Trip93/teensy4_mouse/README.md

# teensy4_mouse
Arduino code for a high speed 8000Hz wired mouse using a teensy 4 MCU. 
This code is inspired by https://github.com/mrjohnk/PMW3360DM-T2QU and https://github.com/SunjunKim/PMW3360_Arduino.

This project includes code for a modified 8000Hz wired mouse.
It uses standard libraries included with the arduino IDE and teensyduino. 

Hardware relevant for this project:

PMW3360 image sensor https://www.pixart.com/products-detail/10/PMW3360DM-T2QU

Teensy4 microcontroller development board https://www.pjrc.com/store/teensy40.html 

Glorious Model O wired version. https://www.pcgamingrace.com/products/glorious-model-o-black

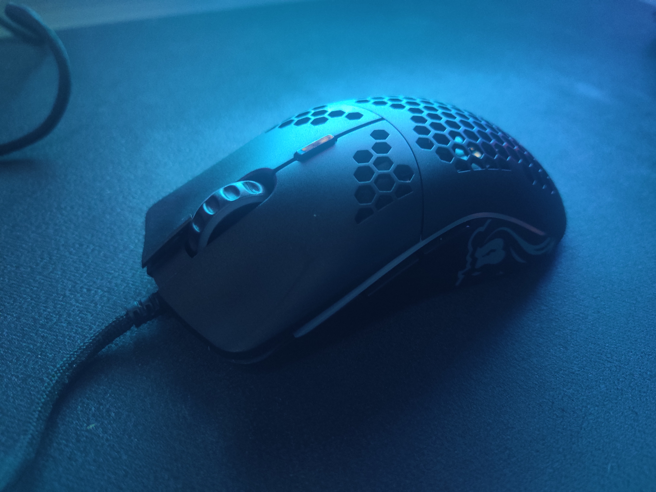
[picture p1: pictures/mouse_top_closed.jpg]

Glorious mouse modified with the teensy internally.

The following connection need to be made to the mouse sensor. The power supply pins are already taken care of by the mouse itself.
The microcontroller of the mouse should also be removed. Recommended is to use a hot air station to remove the microcontroller. 
It should be possible to do this project with any mouse that uses a PMW3360 sensor.
A pinout is given below: 

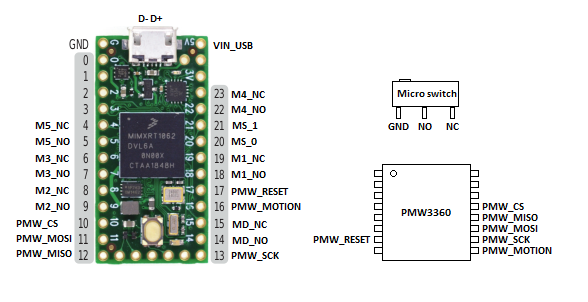
[picture p2: pictures/teensy4_mouse_pinout.png]


The teensy4 uses a microcontroller capable of USB high speed and therefore high polling speed (8000Hz). 
No drivers are required to enable 8000Hz. Signal integrity of the cable is important. 
The cable of the glorious mouse was shortened to 1 meter length and USB data lines were soldered straight to the Teensy4 D- and D+ pads. 
Picture of the modified mouse are given below:

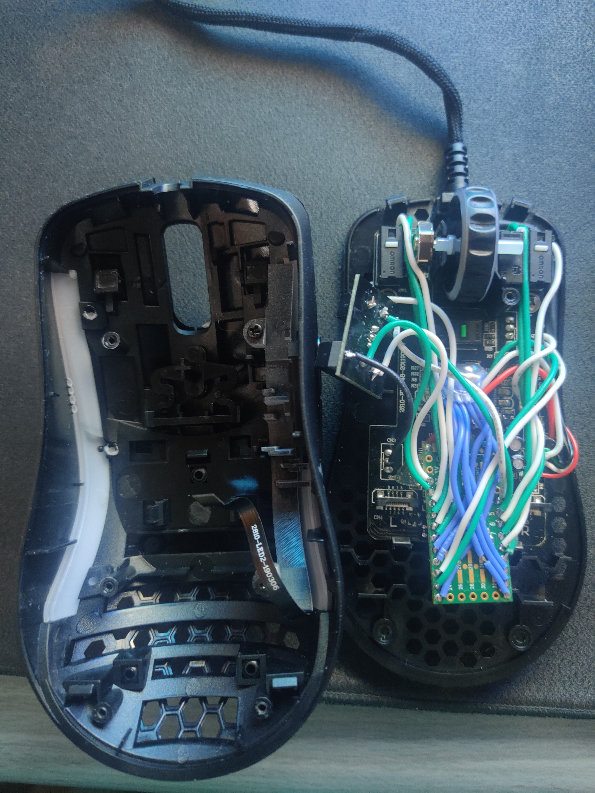
[picture p3: pictures/mouse_top_open.jpg]

Modified mouse top view open shell.

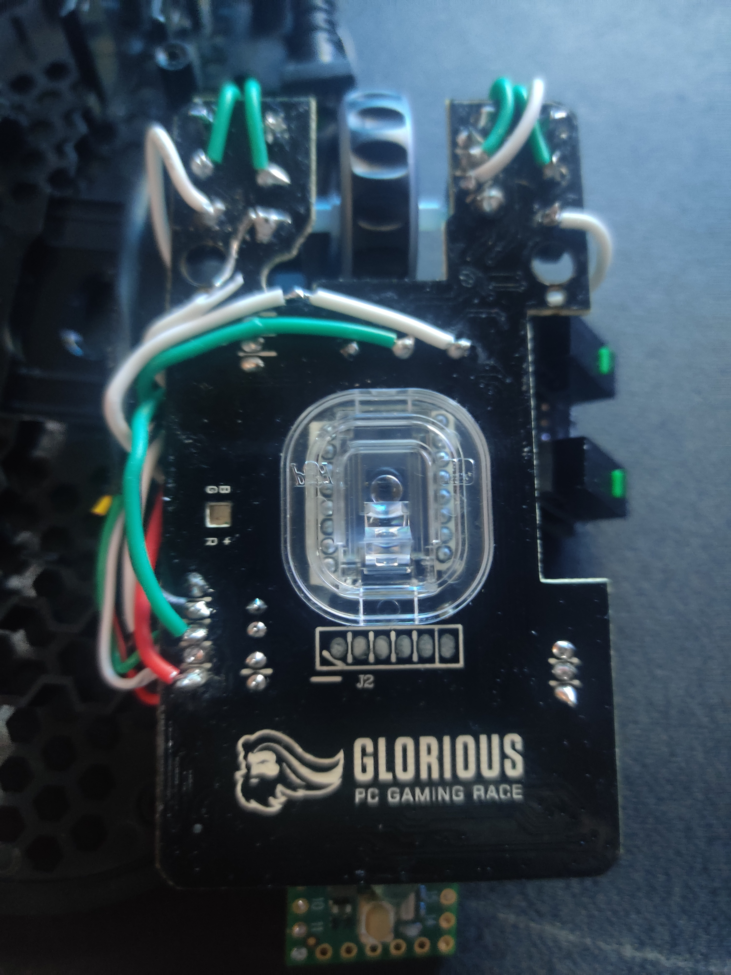
[picture p4: pictures/mouse_bottom_open.jpg]

Modified mouse bottom view open shell.

To verify 8000Hz operation mousetester1.5.3 was used https://www.overclock.net/threads/mousetester-software-reloaded.1590569/ 

Polling rate is limited by the speed at which the user moves the mouse. The graph has shows what happens when the user moves the mouse at varying speeds. 
At low speeds polling rates are closer to a 1000-2000Hz (0.5 - 1mS intervals), moderate speeds average at 4000hz (0.250ms intervals) and high speeds average at 8000Hz.
The PWM3360 adjusts the sensor framerate based on the speed that the user moves it. This can be up to 12000fps.

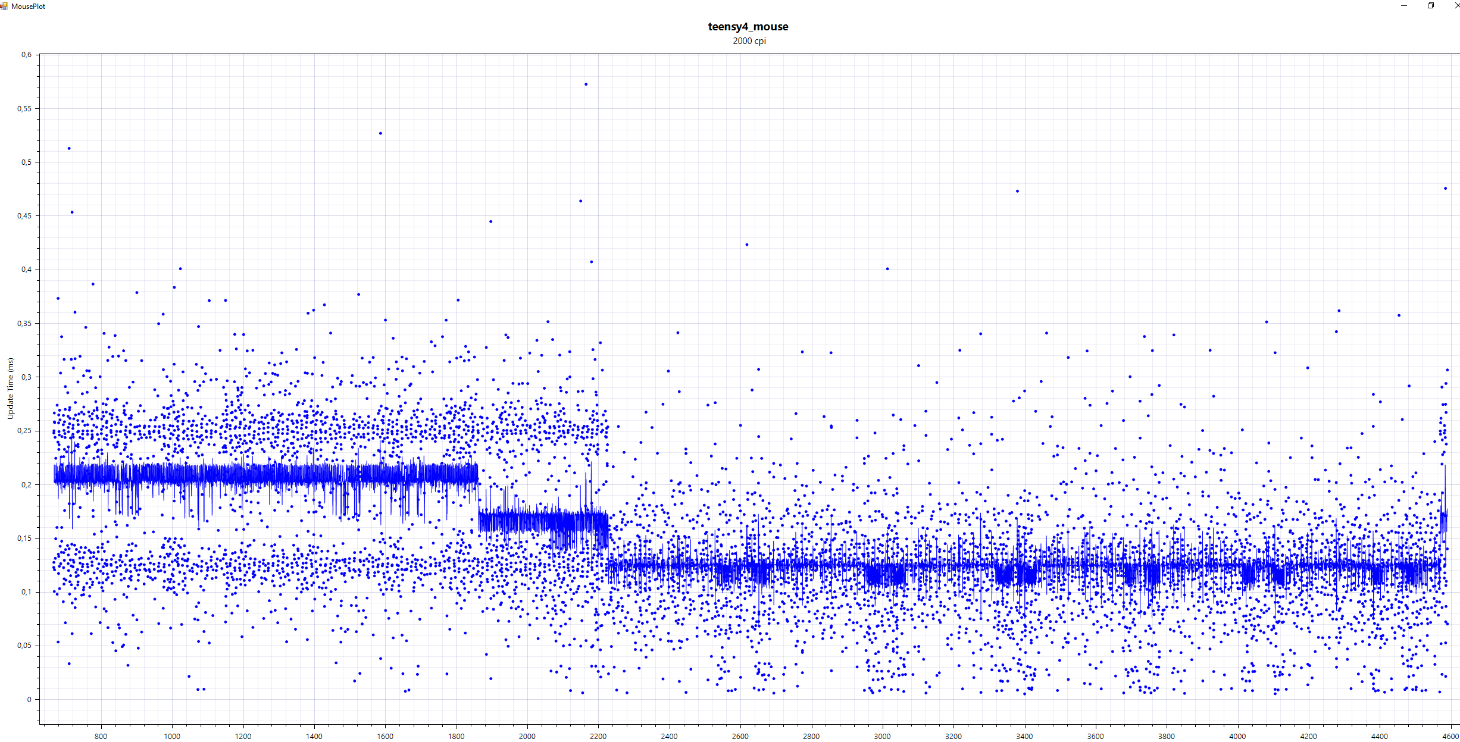
[picture p5: pictures/mousetester_teensy_mouse.png]


Furthermore this modification supports fast button inputs without software based debouncing. 
Both NC and NO connectors of the micro switch are connected to the microcontroller. Enabling fast state change detection without contact bounce problems.

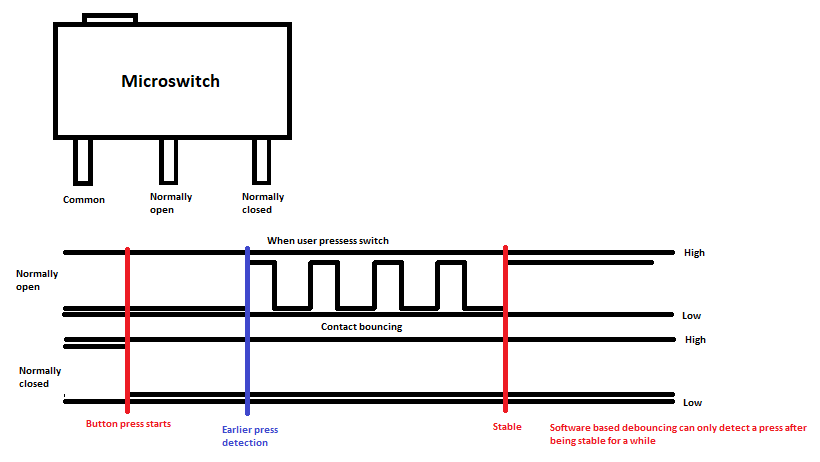
[picture p6: pictures/NC_NO_debouncing.png]


Related links:

If you would like to discuss something about this project I have posted a thread about this project on a few forums.

https://www.overclock.net/threads/8000hz-diy-teensy-4-mouse.1794842/#post-28889289

https://forums.blurbusters.com/viewtopic.php?f=7&p=73567#p73567

https://forum.pjrc.com/threads/68553-Teensy-4-high-speed-mouse

During the build process I also shot some video footage. It is possible that I will release a video somewhere in the (near) future. (no promises)
Since I am not very experienced with video editing and the footage is not super high quality it might take some time.
