Trip93/teensy4_mouse/(commit log)

2021-11-02 Update teensy4_mouse.ino
    - Added adjustable polling speed using seperate timer.
    - Uses 16 bit values instead of 8 bit for x and y. Backwards compatible with USB_mouse_move but for improved max control speed at lower polling speeds 16 bit is required.
    - See teensy4_cores_patch folder if you want to add 16 bit support. (I asked if this change could be added to future teensyduino versions)
    - Slight changes in naming conventions and replaced magic numbers with actual descriptions from the datasheet
    [teensy4_mouse.ino]
2021-11-02 Update teensy4_mouse.h
    - Replaced magic numbers with proper names from the PMW3360 datasheet
    [teensy4_mouse.h]
2021-11-02 Create teensy4_cores_patch.md
    Optional 16 bit support for lower polling rates
